aaronw2/slimevr/slimevr.kicad_pcb

## KiCad design slimevr.kicad_pcb (2022-04-06)

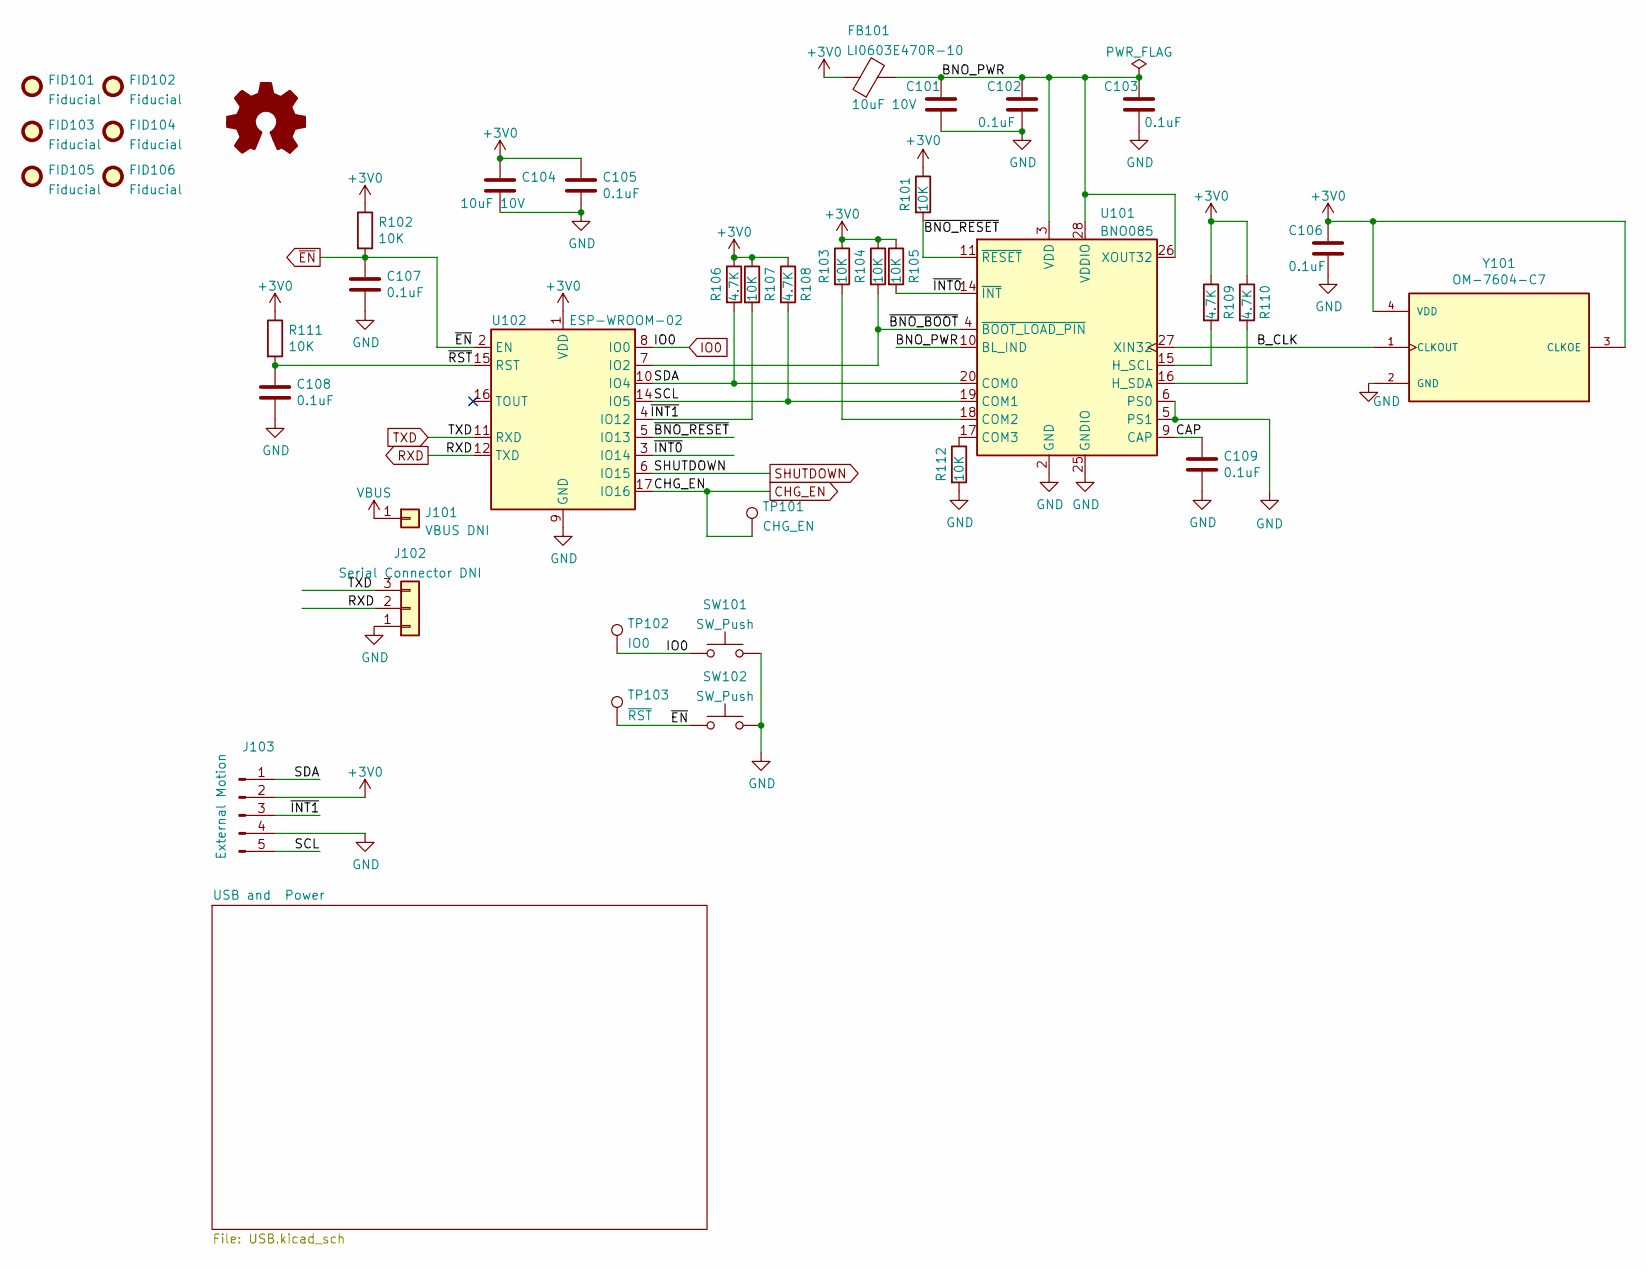
[picture p1: schematic slimevr.kicad_sch, Slime VR Motion Tracker]

Parts:
C101, C104: 10uF 10V; C_0603_1608Metric; MPN CL10A106MP8NNNC
C102, C103, C105, C106, C107, C108, C109: 0.1uF; C_0603_1608Metric; MPN C0603C104M3RAC7867
FB101: LI0603E470R-10; L_0603_1608Metric; MPN LI0603E470R-10
FID101, FID102, FID103, FID104, FID105, FID106: Fiducial; Fiducial_0.5mm_Mask1mm
J101: VBUS DNI; PinHeader_1x01_P2.54mm_Vertical
J102: Serial Connector DNI; PinHeader_1x03_P2.54mm_Vertical
J103: External Motion; JST_PH_S5B-PH-K_1x05_P2.00mm_Horizontal; MPN B5B-PH-SM4-TBT(LF)(SN)
LOGO101: Logo_Open_Hardware_Small; OSHW-Logo2_7.3x6mm_SilkScreen
R101, R102, R103, R104, R105, R107, R111, R112: 10K; R_0603_1608Metric; MPN RC0603FR-0710KL
R106, R108, R109, R110: 4.7K; R_0603_1608Metric; MPN RC0603FR-074K7L
SW101, SW102: SW_Push; SW_SPST_CK_KXT3; MPN KXT 331 LHS
TP101: CHG_EN; TestPoint_THTPad_1.0x1.0mm_Drill0.5mm
TP102: IO0; TestPoint_THTPad_1.0x1.0mm_Drill0.5mm
TP103: ~{RST}; TestPoint_THTPad_1.0x1.0mm_Drill0.5mm
U101: BNO085; LGA-28_5.2x3.8mm_P0.5mm; MPN BNO085
U102: ESP-WROOM-02; MPN ESP-WROOM-02D (4MB)
Y101: OM-7604-C7; OSC_OM-7604-C7; PARTREV 4.2/06.2019

Connections:
+3V0: C104.1, C105.1, C106.1, FB101.1, J103.2, R101.1, R102.1, R103.1, R104.1, R105.1, R106.1, R107.1, R108.1, R109.1, R110.1, R111.1, U102.1 (VDD), Y101.3 (CLKOE), Y101.4 (VDD); also elsewhere on the board
/BNO_PWR: C101.1, C102.1, C103.1, FB101.2, U101.3 (VDD), U101.10 (BL_IND), U101.26 (XOUT32), U101.28 (VDDIO)
/B_CLK: U101.27 (XIN32), Y101.1 (CLKOUT)
/CAP: C109.1, U101.9 (CAP)
/SCL: J103.5, R108.2, U101.19 (COM1), U102.14 (IO5)
/SDA: J103.1, R106.2, U101.20 (COM0), U102.10 (IO4)
/~BNO_BOOT: R104.2, U101.4 (~BOOT_LOAD_PIN), U102.7 (IO2)
/~BNO_RESET: R101.2, U101.11 (~RESET), U102.5 (IO13)
/~INT0: R105.2, U101.14 (~INT), U102.3 (IO14)
/~INT1: J103.3, R107.2, U102.4 (IO12)
/~RST: C108.1, R111.2, U102.15 (RST)
CHG_EN: TP101.1, U102.17 (IO16); also elsewhere on the board
GND: C101.2, C102.2, C103.2, C104.2, C105.2, C106.2, C107.2, C108.2, C109.2, J102.1, J103.4, R112.2, SW101.2, SW102.2, U101.2 (GND), U101.5 (PS1), U101.6 (PS0), U101.25 (GNDIO), U102.9 (GND), U102.13 (GND), U102.18 (GND), U102.19 (GND), Y101.2 (GND); also elsewhere on the board
IO0: SW101.1, TP102.1, U102.8 (IO0); also elsewhere on the board
unnamed: R103.2, U101.18 (COM2)
unnamed: R112.1, U101.17 (COM3)
unnamed: R109.2, U101.15 (H_SCL)
unnamed: R110.2, U101.16 (H_SDA)
RXD: J102.2, U102.12 (TXD); also elsewhere on the board
SHUTDOWN: U102.6 (IO15); also elsewhere on the board
TXD: J102.3, U102.11 (RXD); also elsewhere on the board
VBUS: J101.1; also elsewhere on the board
~EN: C107.1, R102.2, SW102.1, TP103.1, U102.2 (EN); also elsewhere on the board

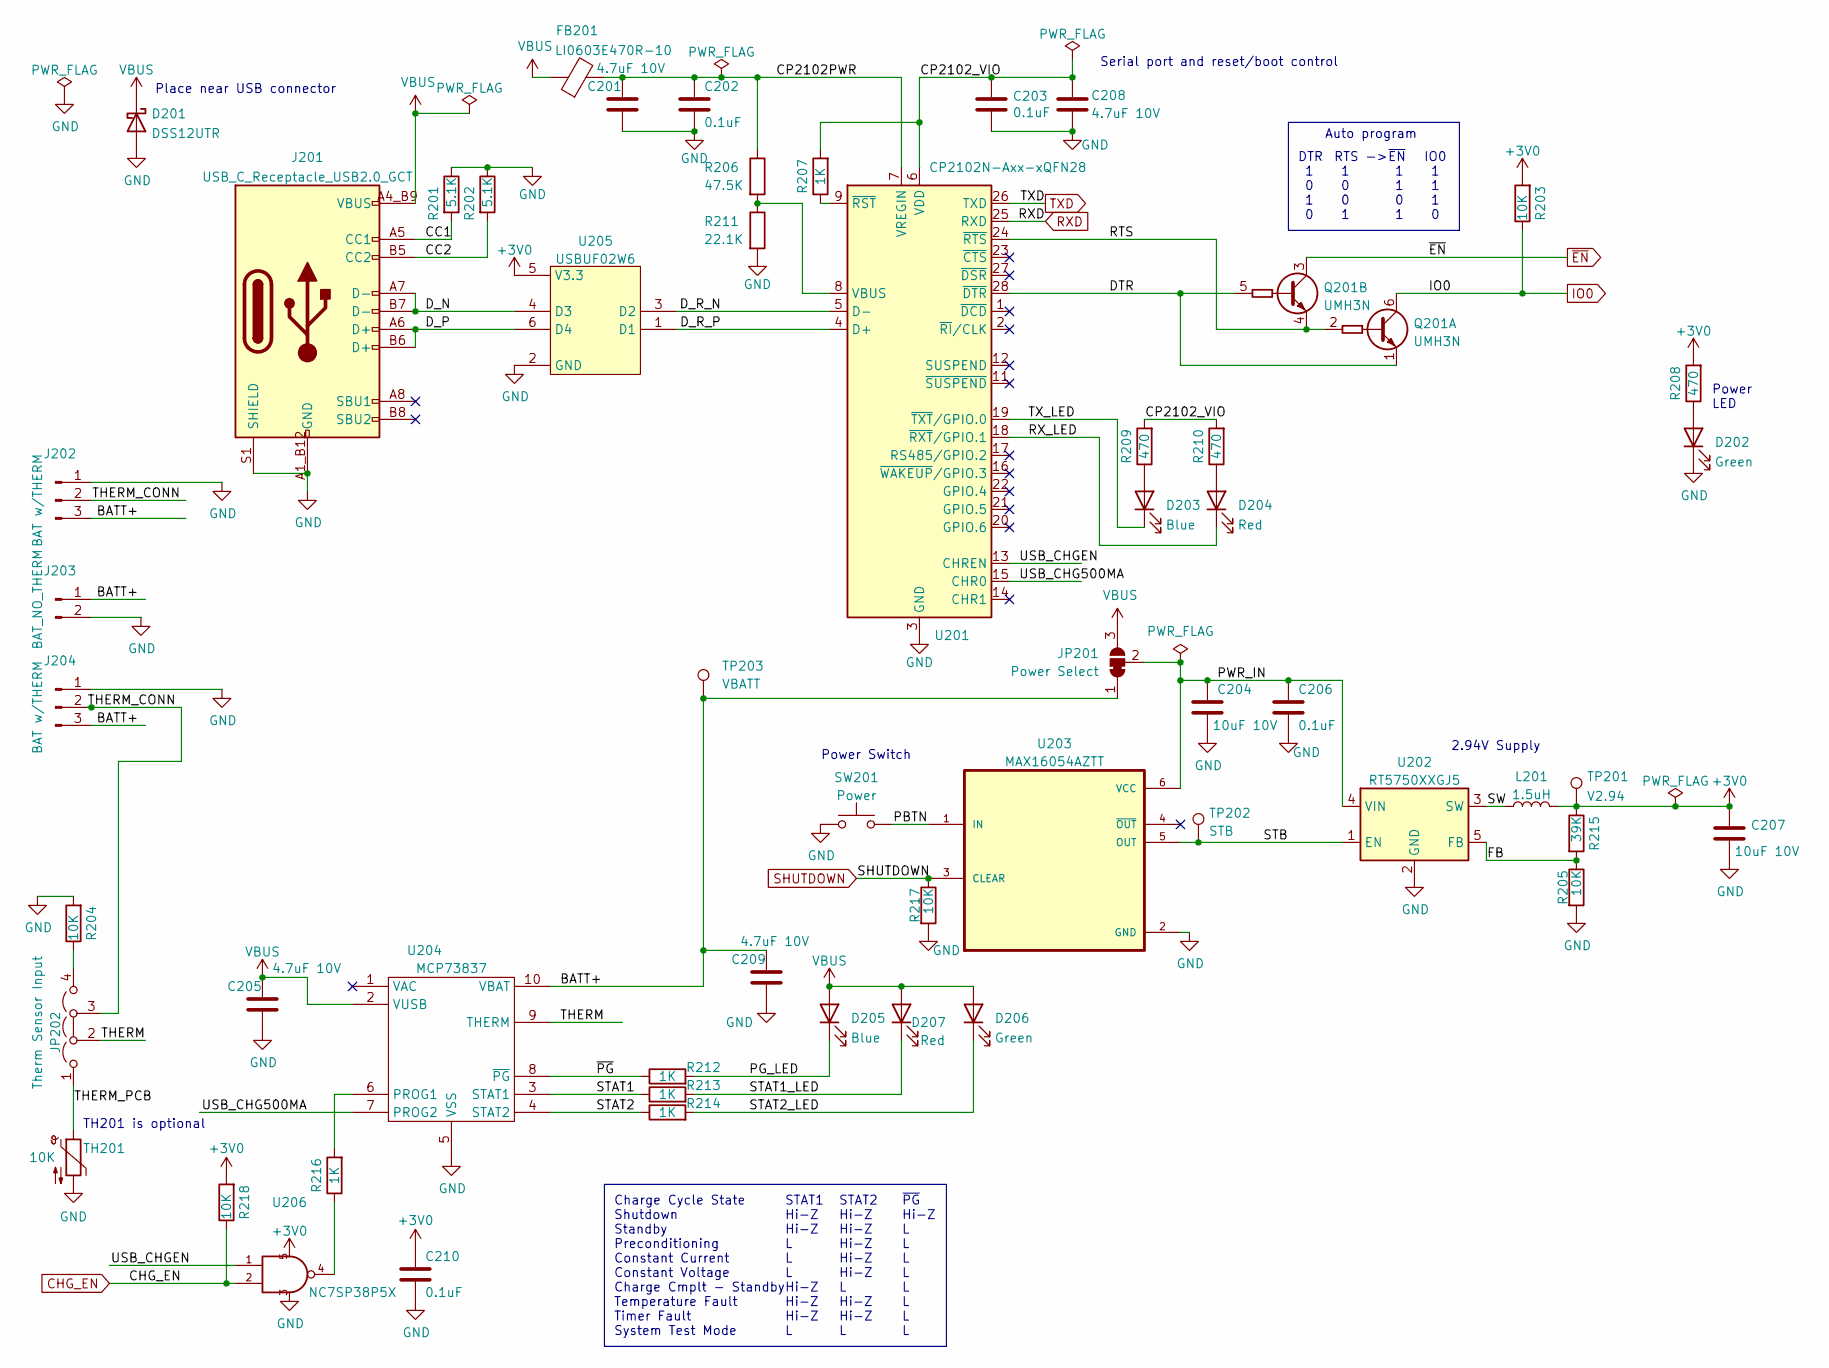
[picture p2: schematic USB.kicad_sch, Slime VR Motion Tracker]

Parts:
C201, C205, C208, C209: 4.7uF 10V; C_0603_1608Metric; MPN CL10A475KP8NNNC
C202, C203, C206, C210: 0.1uF; C_0603_1608Metric; MPN C0603C104M3RAC7867
C204, C207: 10uF 10V; C_0603_1608Metric; MPN CL10A106MP8NNNC
D201: DSS12UTR; D_SOD-123F; MPN DSS12UTR
D202, D206: Green; LED_0603_1608Metric; MPN 150060VS55040
D203, D205: Blue; LED_0603_1608Metric; MPN 150060BS55040
D204, D207: Red; LED_0603_1608Metric; MPN 150060SS55040
FB201: LI0603E470R-10; L_0603_1608Metric; MPN LI0603E470R-10
J201: USB_C_Receptacle_USB2.0_GCT; GCT_USB4105-GF-A; MPN USB4105-GF-A
J202: BAT w/THERM; SolderWire-0.1sqmm_1x03_P3.6mm_D0.4mm_OD1mm
J203: BAT_NO_THERM; JST_PH_S2B-PH-K_1x02_P2.00mm_Horizontal; MPN B2B-PH-SM4-TB(LF)(SN)
J204: BAT w/THERM; Molex_PicoBlade_53048-0310_1x03_P1.25mm_Horizontal; MPN 0530480350
JP201: Power Select; SolderJumper-3_P1.3mm_Bridged12_RoundedPad1.0x1.5mm
JP202: Therm Sensor Input; SolderJumper-4_P1.3mm_Bridged23_RoundedPad1.0x1.5mm
L201: 1.5uH; L_1008_2520Metric; MPN DFE252010F-1R5M=P2
Q201: UMH3N; SOT-363_SC-70-6
R201, R202: 5.1K; R_0603_1608Metric; MPN RC0603FR-075K1L
R203, R204, R205, R217, R218: 10K; R_0603_1608Metric; MPN RC0402FR-070RL
R206: 47.5K; R_0603_1608Metric
R207, R212, R213, R214, R216: 1K; R_0603_1608Metric; MPN RC0603FR-071KL
R208, R209, R210: 470; R_0603_1608Metric; MPN RC0603FR-07470RL
R211: 22.1K; R_0603_1608Metric
R215: 39K; R_0603_1608Metric; MPN RC0603FR-0739KL
SW201: Power; Panasonic_EVQPUL_EVQPUC; MPN EVQ-PUD02K
TH201: 10K; R_0603_1608Metric; MPN NCU18XH103E60RB
TP201: V2.94; TestPoint_Keystone_5000-5004_Miniature
TP202: STB; TestPoint_THTPad_1.0x1.0mm_Drill0.5mm
TP203: VBATT; TestPoint_THTPad_1.0x1.0mm_Drill0.5mm
U201: CP2102N-Axx-xQFN28; QFN-28-1EP_5x5mm_P0.5mm_EP3.35x3.35mm; MPN CP2102N-A02-GQFN28R
U202: RT5750XXGJ5; TSOT-23-5; MPN RT5750BHGJ5
U203: MAX16054AZTT; TSOT-23-6; MPN MAX16054AZT+T
U204: MCP73837; DFN-10-1EP_3x3mm_P0.5mm_EP1.55x2.48mm; MPN MCP73837-FJI/MF
U205: USBUF02W6; SOT-323-6L
U206: NC7SP38P5X; SOT-353_SC-70-5

Connections:
+3V0: C207.1, C210.1, L201.2, R203.2, R208.2, R215.1, R218.2, TP201.1, U205.5 (V3.3), U206.5 (VCC); also elsewhere on the board
/USB and Power/BATT+: C209.1, J202.3, J203.1, J204.3, JP201.1 (A), TP203.1, U204.10 (VBAT)
/USB and Power/CC1: J201.A5 (CC1), R201.2
/USB and Power/CC2: J201.B5 (CC2), R202.2
/USB and Power/CP2102PWR: C201.1, C202.1, FB201.2, R206.1, U201.7 (VREGIN)
/USB and Power/CP2102_VIO: C203.1, C208.1, R207.2, R209.2, R210.2, U201.6 (VDD)
/USB and Power/DTR: Q201.1 (E1), Q201.5 (B2), U201.28 (~DTR)
/USB and Power/D_N: J201.A7 (D-), J201.B7 (D-), U205.4 (D3)
/USB and Power/D_P: J201.A6 (D+), J201.B6 (D+), U205.6 (D4)
/USB and Power/D_R_N: U201.5 (D-), U205.3 (D2)
/USB and Power/D_R_P: U201.4 (D+), U205.1 (D1)
/USB and Power/FB: R205.1, R215.2, U202.5 (FB)
/USB and Power/PBTN: SW201.2, U203.1 (IN)
/USB and Power/PG_LED: D205.1 (K), R212.2
/USB and Power/PWR_IN: C204.1, C206.1, JP201.2 (C), U202.4 (VIN), U203.6 (VCC)
/USB and Power/RTS: Q201.2 (B1), Q201.4 (E2), U201.24 (~RTS)
/USB and Power/RX_LED: D204.1 (K), U201.18 (~RXT/GPIO.1)
/USB and Power/STAT1: R213.1, U204.3 (STAT1)
/USB and Power/STAT1_LED: D207.1 (K), R213.2
/USB and Power/STAT2: R214.1, U204.4 (STAT2)
/USB and Power/STAT2_LED: D206.1 (K), R214.2
/USB and Power/STB: TP202.1, U202.1 (EN), U203.5 (OUT)
/USB and Power/SW: L201.1, U202.3 (SW)
/USB and Power/THERM: JP202.2 (C), U204.9 (THERM)
/USB and Power/THERM_CONN: J202.2, J204.2, JP202.3 (B)
/USB and Power/THERM_PCB: JP202.1 (A), TH201.1
/USB and Power/TX_LED: D203.1 (K), U201.19 (~TXT/GPIO.0)
/USB and Power/USB_CHG500MA: U201.15 (CHR0), U204.7 (PROG2)
/USB and Power/USB_CHGEN: U201.13 (CHREN), U206.1 (A)
/USB and Power/~PG: R212.1, U204.8 (~PG)
CHG_EN: R218.1, U206.2 (B); also elsewhere on the board
GND: C201.2, C202.2, C203.2, C204.2, C205.2, C206.2, C207.2, C208.2, C209.2, C210.2, D201.2 (A), D202.1 (K), J201.A1_B12 (GND), J201.B1_A12 (GND), J201.S1 (SHIELD), J201.S2 (SHIELD), J201.S3 (SHIELD), J201.S4 (SHIELD), J202.1, J203.2, J204.1, R201.1, R202.1, R204.2, R205.2, R211.2, R217.2, SW201.1, TH201.2, U201.3 (GND), U201.29 (GND), U202.2 (GND), U203.2 (GND), U204.5 (VSS), U204.11 (VSS), U205.2 (GND), U206.3 (GND); also elsewhere on the board
IO0: Q201.6 (C1), R203.1; also elsewhere on the board
unnamed: D202.2 (A), R208.1
unnamed: D203.2 (A), R209.1
unnamed: D204.2 (A), R210.1
unnamed: JP202.4, R204.1
unnamed: R206.2, R211.1, U201.8 (VBUS)
unnamed: R207.1, U201.9 (~RST)
unnamed: R216.1, U206.4 (Y)
unnamed: R216.2, U204.6 (PROG1)
RXD: U201.25 (RXD); also elsewhere on the board
SHUTDOWN: R217.1, U203.3 (CLEAR); also elsewhere on the board
TXD: U201.26 (TXD); also elsewhere on the board
VBUS: C205.1, D201.1 (K), D205.2 (A), D206.2 (A), D207.2 (A), FB201.1, J201.A4_B9 (VBUS), J201.B4_A9 (VBUS), JP201.3 (B), U204.2 (VUSB); also elsewhere on the board
~EN: Q201.3 (C2); also elsewhere on the board

Notes on the sheet:
Power Switch
Charge Cycle State Shutdown Standby Preconditioning Constant Current Constant Voltage Charge Cmplt - Standby Temperature Fault Timer Fault System Test Mode
Auto program
STAT1 Hi-Z Hi-Z L L L Hi-Z Hi-Z Hi-Z L
Place near USB connector
TH201 is optional
Power LED
RTS -> 1 0 0 1
IO0 1 1 1 0
~{EN} 1 1 0 1
STAT2 Hi-Z Hi-Z Hi-Z Hi-Z Hi-Z L Hi-Z Hi-Z L
DTR 1 0 1 0
2.94V Supply
~{PG} Hi-Z L L L L L L L L
Serial port and reset/boot control

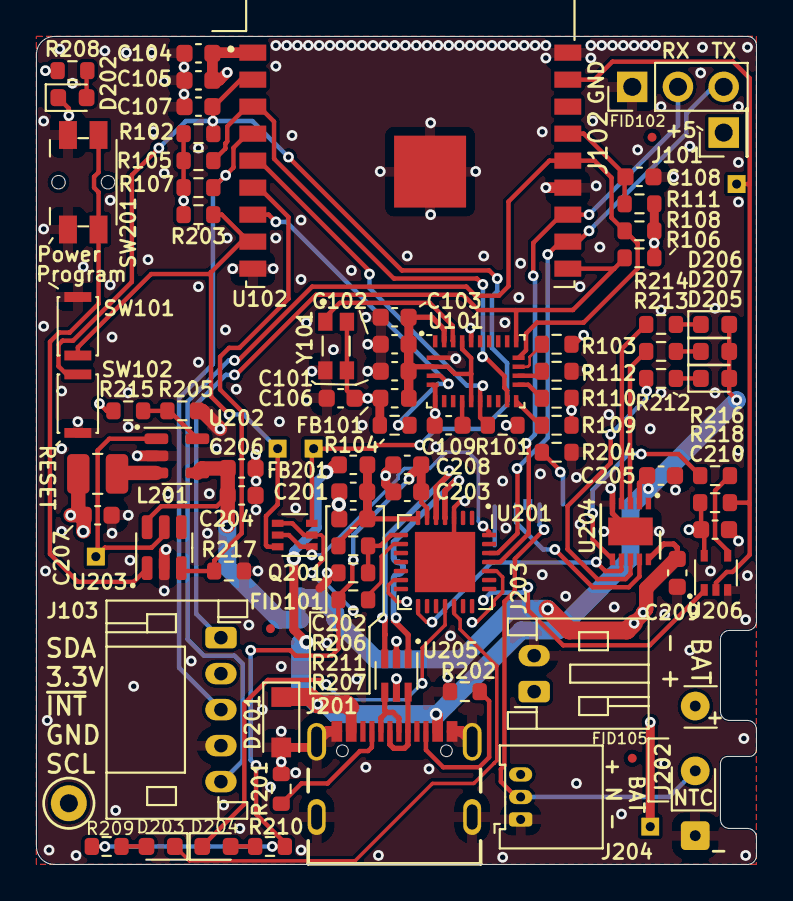
[picture p3: board slimevr.kicad_pcb from above]

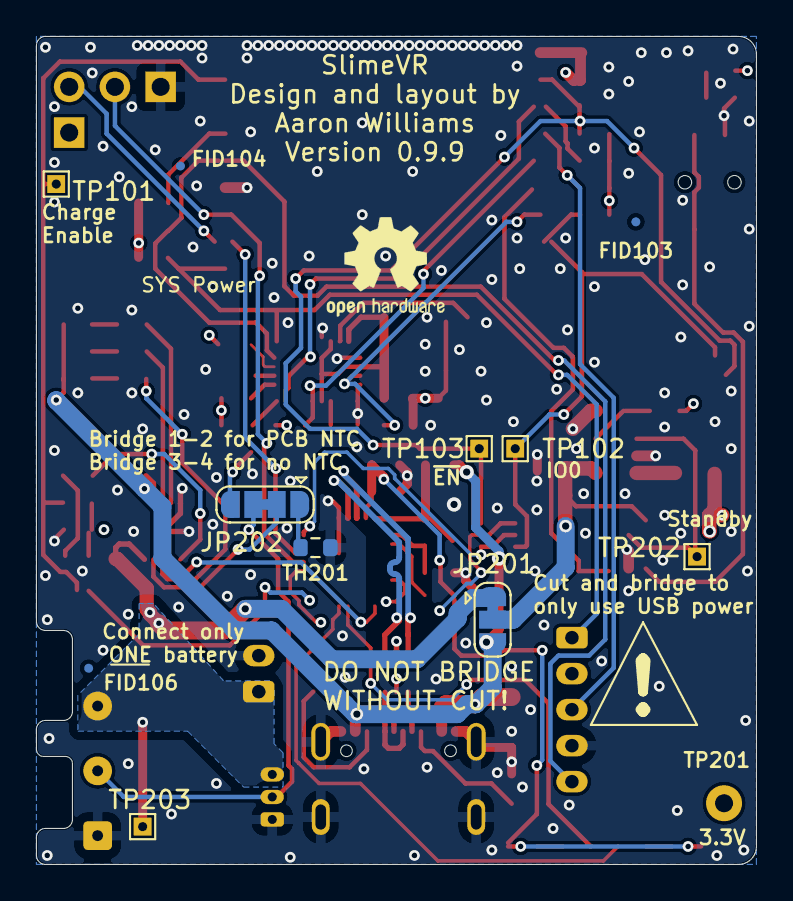
[picture p4: board slimevr.kicad_pcb from below]

Board: 4 copper layers, 40.0 x 46.0 mm, 95 parts (12 on the bottom side), 60 nets.
