aaronw2/slimevr/SlimeVR-Motion/SlimeVR-Motion.kicad_pcb

## KiCad design SlimeVR-Motion/SlimeVR-Motion.kicad_pcb (2022-04-06)

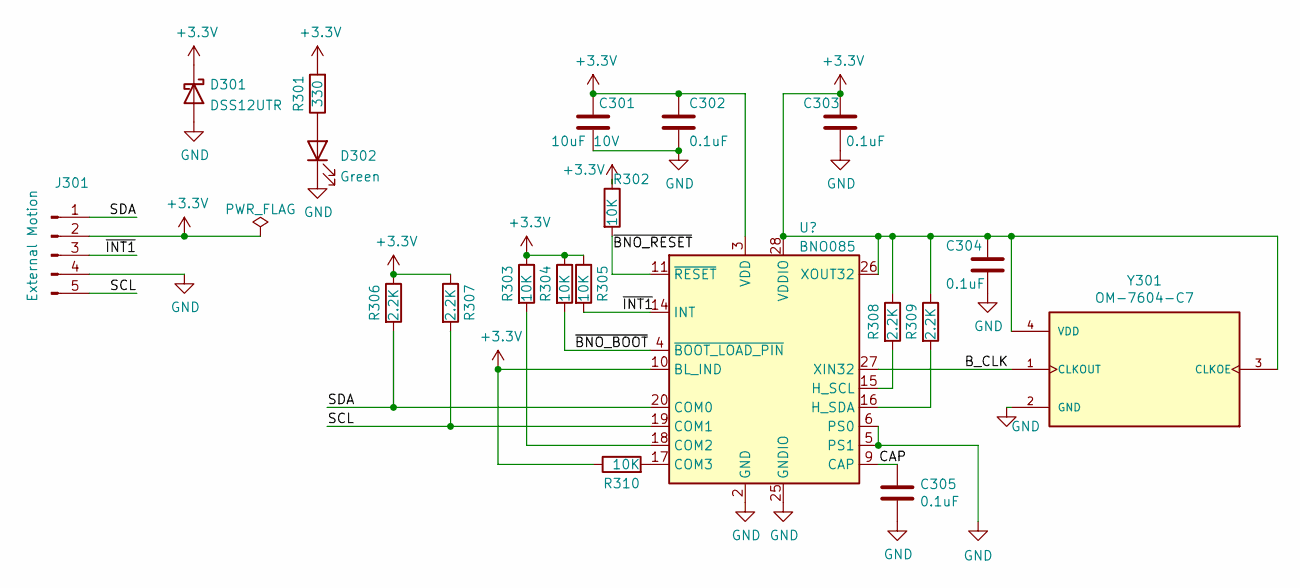
[picture p5: schematic SlimeVR-Motion.kicad_sch, Slime VR Motion Daughter Card]

Parts:
C301: 10uF 10V; C_0603_1608Metric; MPN CL10A106MP8NNNC
C302, C303, C304, C305: 0.1uF; C_0603_1608Metric; MPN C0603C104M3RAC7867
D301: DSS12UTR; D_SOD-123F; MPN DSS12UTR
D302: Green; LED_0603_1608Metric; MPN 150060VS55040
J301: External Motion; JST_PH_S5B-PH-K_1x05_P2.00mm_Horizontal; MPN B5B-PH-SM4-TBT(LF)(SN)
R301: 330; R_0603_1608Metric; MPN RC0603FR-07330RL
R302, R303, R304, R305, R310: 10K; R_0603_1608Metric; MPN RC0402FR-070RL
R306, R307, R308, R309: 2.2K; R_0603_1608Metric; MPN RC0603FR-074K7L
Y301: OM-7604-C7; OSC_OM-7604-C7; PARTREV 4.2/06.2019

Connections:
+3V3: C301.1, C302.1, C303.1, C304.1, D301.1 (K), J301.2, R301.2, R302.1, R303.1, R304.1, R305.1, R306.1, R307.1, R308.1, R309.1, R310.1, Y301.3 (CLKOE), Y301.4 (VDD); also elsewhere on the board
/B_CLK: Y301.1 (CLKOUT); also elsewhere on the board
/CAP: C305.1; also elsewhere on the board
/SCL: J301.5, R307.2; also elsewhere on the board
/SDA: J301.1, R306.2; also elsewhere on the board
/~BNO_BOOT: R304.2; also elsewhere on the board
/~BNO_RESET: R302.2; also elsewhere on the board
/~INT1: J301.3, R305.2; also elsewhere on the board
GND: C301.2, C302.2, C303.2, C304.2, C305.2, D301.2 (A), D302.1 (K), J301.4, Y301.2 (GND); also elsewhere on the board
unnamed: D302.2 (A), R301.1
unnamed 10: R303.2; also elsewhere on the board
unnamed 11: R308.2; also elsewhere on the board
unnamed 12: R309.2; also elsewhere on the board
unnamed 13: R310.2; also elsewhere on the board

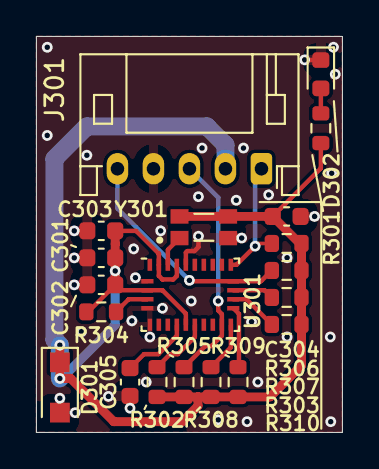
[picture p6: board SlimeVR-Motion.kicad_pcb from above]

Board: 2 copper layers, 17.0 x 22.0 mm, 20 parts (0 on the bottom side), 14 nets.

Other parts of the board:
U301: BNO085; LGA-28_5.2x3.8mm_P0.5mm

Their connections:
+3V3: U301.3 (VDD), U301.10 (BL_IND), U301.26 (XOUT32), U301.28 (VDDIO); also elsewhere on the board
/B_CLK: U301.27 (XIN32); also elsewhere on the board
/CAP: U301.9 (CAP); also elsewhere on the board
/SCL: U301.19 (COM1); also elsewhere on the board
/SDA: U301.20 (COM0); also elsewhere on the board
/~BNO_BOOT: U301.4 (~BOOT_LOAD_PIN); also elsewhere on the board
/~BNO_RESET: U301.11 (~RESET); also elsewhere on the board
/~INT1: U301.14 (INT); also elsewhere on the board
GND: U301.2 (GND), U301.5 (PS1), U301.6 (PS0), U301.25 (GNDIO); also elsewhere on the board
unnamed 10: U301.18 (COM2); also elsewhere on the board
unnamed 11: U301.15 (H_SCL); also elsewhere on the board
unnamed 12: U301.16 (H_SDA); also elsewhere on the board
unnamed 13: U301.17 (COM3); also elsewhere on the board
