aaronw2/slimevr/(commit log)

2022-04-06 Initial checkin of version 0.9.9 with license
    [Charger.kicad_sch, Charger.sch, SlimeVR-Motion.kicad_pcb, SlimeVR-Motion.kicad_sch, USB.kicad_sch, USB.sch, motion.kicad_sch, slimevr.kicad_pcb]
2022-04-06 Minor cleanup
    [USB.kicad_sch, slimevr.kicad_pcb, slimevr.kicad_sch]
