aaronw2/slimevr/(notices)

Notices in the files:
slimevr.kicad_sch:
Copyright © 2022 Aaron Williams
